thefuzzman/WSP_YM_BB/README.md

NOTE: THIS PROJECT IS A WORK IN PROGRESS AS WE BUILD THESE IN REAL TIME WITH OUR YOUTH GROUP. 

NOTE: They have little coding experience, so code is heavily commented which may just be noise to you

NOTE: THAT MEANS THINGS ARE CHANGING AND THINGS WILL CHANGE

NOTE: USE AT YOUR OWN RISK

Having said all of that, we have working code and design, so v1.1.0 is out the door.

This project is to create ant weight battle bots that use the following components and/or constraints:

- ESP32 based (All wiring, etc. in this sketch is for ESP32-S3-Zero (mini) )
- N20 motors (with or without encoders, wiring diagrams below for either)
- BLE based connection to an Android device running the APK in this repo
- - 150g max (5.3oz)
- A fail-safe is required (bot must stop if signal is lost in a minimal amount of time)
- No liquid-based weapons, glue, adhesives, or explosives.
- Generally, no nets, fabrics, or entangling weapons.
- All sharp edges must be covered when outside the arena.
- Robots must be constructed primarily from 3D printed parts
**- Only PLA is allowed as a material (except TPU 85/90 for wheel covers if not using o-rings for grip)
SEE THE "Combat Robot Build Guide" for parts, assembly, programming, and more

Android APK is not compatible with iOS (Apple)

Download directly to your device.  Open your file manager (typically Files).  You might need to enable untrusted sources.  

Yes, I am an untrusted source.  Just a random guy on the internet.  The folks we're doing this with, however, know me and know this is what we're using.

Want the source?  https://github.com/thefuzzman/AntbotAPK/tree/main.

NOTE that the APK is entirely vibe coded.  Thank you Anthropic!
