thefuzzman/WSP_YM_BB/(commit log)

2026-04-19 Added ESP32Servo logic - initial attempt
2026-04-20 Update README.md
    Adding links to hardware, wiring I'm testing, and more
2026-04-21 Added potential wiring diagrams from Claude
2026-04-22 Added image to README for wiring diagram and tables
2026-04-22 Updated some logic. Various fixes.
    [BattleBots.ino]
2026-04-23 fixed motors still running without input
    [BattleBots.ino]
2026-04-26 updates to pins, etc for ESP32-S3-Zero (Mini)
2026-05-01 Changed RBG pin for ESP32 Zero board
2026-07-12 adding wiring digram for ESC
2026-07-12 updated sketch to support esc for driving weapons
2026-07-15 Uploaded ESC wiring diagram
2026-07-17 added ESC plus ESP32 option
2026-07-17 added wiring for esp32 plus esc diagram
2026-07-20 updated - fixed weapon ESC
    [BattleBots.ino]
2026-07-21 removed ESC based content
